jessecheu/port/README.md

# EECS149 Fall 2023 Final Project: Port
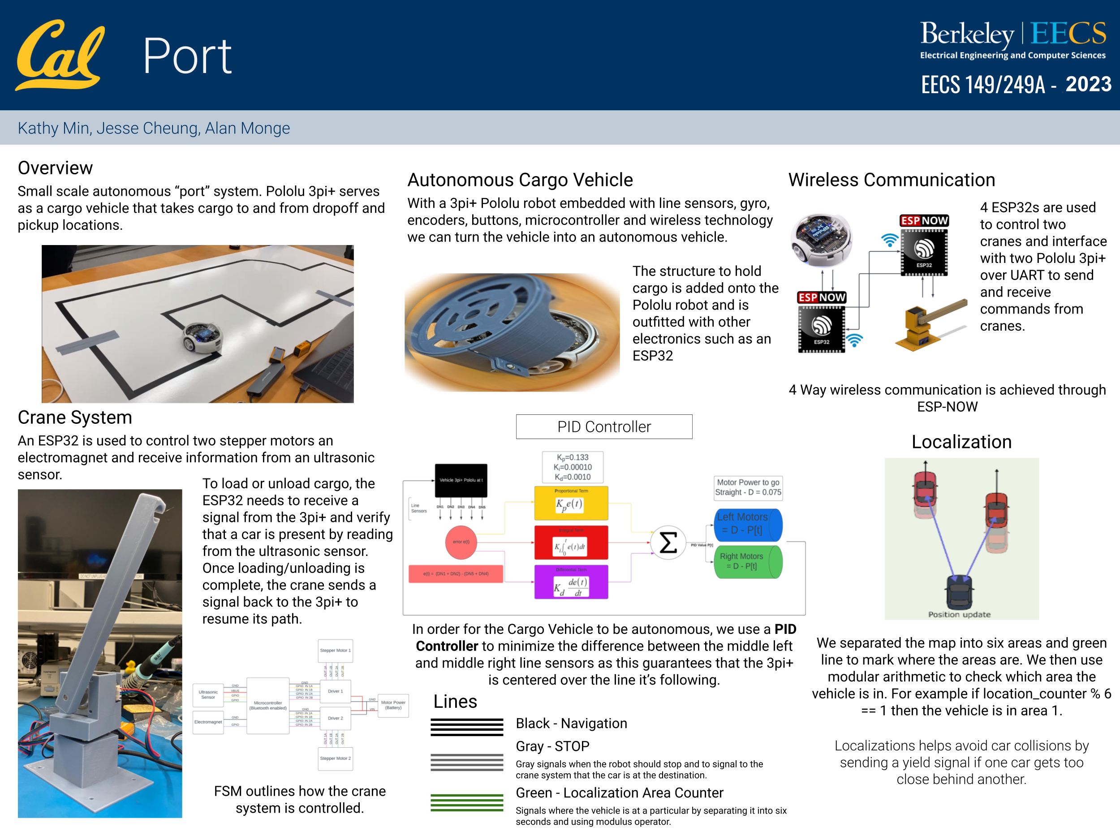
[picture p1: Poster_Landscape.png]
Picture of Port's Poster
