jessecheu/port/crane/esp32_check_mac_address/esp32_check_mac_address.ino

// Complete Instructions to Get and Change ESP MAC Address: https://RandomNerdTutorials.com/get-change-esp32-esp8266-mac-address-arduino/

#include <WiFi.h>
#include <esp_wifi.h>

void setup(){
  Serial.begin(115200);
  Serial.println();
  Serial.print("ESP Board MAC Address:  ");
  Serial.println(WiFi.macAddress());
}
 
void loop(){

}
