jessecheu/port/crane/stepper1/stepper1.ino

#define stepPin 15
#define dirPin 32

void setup() {
  pinMode(stepPin, OUTPUT);
  pinMode(dirPin, OUTPUT);
}

void loop() {
  digitalWrite(dirPin,HIGH);
  for (int x = 0; x<200; x++) {
    digitalWrite(stepPin,HIGH);
    delayMicroseconds(1000);
    digitalWrite(stepPin, LOW);
    delayMicroseconds(1000);
  }
  delay(1000); // 1 second delay.                           

  digitalWrite(dirPin, LOW); // change direction
  for (int x = 0; x<200; x++) {
    digitalWrite(stepPin,HIGH);
    delayMicroseconds(1000);
    digitalWrite(stepPin, LOW);
    delayMicroseconds(1000);
  }
  delay(1000);
}
