jessecheu/port/robot-lib/src/hc_sr04.c

/// @file hc_sr04.c
/// implementation for the hc_sr04 sensor

/*
    hc_sr04.c
    A library for ultrasonic ranger

    Copyright (c) 2012 seeed technology inc.
    Website    : www.seeed.cc
    Author     : LG, FrankieChu
    Create Time: Jan 17,2013
    Change Log :

    The MIT License (MIT)

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
    THE SOFTWARE IS PROVIDED "AS IS", WITHOUT WARRANTY OF ANY KIND, EXPRESS OR
    IMPLIED, INCLUDING BUT NOT LIMITED TO THE WARRANTIES OF MERCHANTABILITY,
    FITNESS FOR A PARTICULAR PURPOSE AND NONINFRINGEMENT. IN NO EVENT SHALL THE
    AUTHORS OR COPYRIGHT HOLDERS BE LIABLE FOR ANY CLAIM, DAMAGES OR OTHER
    LIABILITY, WHETHER IN AN ACTION OF CONTRACT, TORT OR OTHERWISE, ARISING FROM,
    OUT OF OR IN CONNECTION WITH THE SOFTWARE OR THE USE OR OTHER DEALINGS IN
    THE SOFTWARE.
*/

#include <hardware/i2c.h>
#include <hardware/gpio.h>
#include <stdio.h>
#include <string.h>
#include <inttypes.h>
#include "<hc_sr04.h>"

#ifdef ARDUINO_ARCH_STM32F4

static uint32_t MicrosDiff(uint32_t begin, uint32_t end) {
    return end - begin;
}

static uint32_t pulseIn(uint32_t pin, uint32_t state, uint32_t timeout = 1000000L) {
    uint32_t begin = micros();

    // wait for any previous pulse to end
    while (digitalRead(pin)) if (MicrosDiff(begin, micros()) >= timeout) {
            return 0;
        }

    // wait for the pulse to start
    while (!digitalRead(pin)) if (MicrosDiff(begin, micros()) >= timeout) {
            return 0;
        }
    uint32_t pulseBegin = micros();

    // wait for the pulse to stop
    while (digitalRead(pin)) if (MicrosDiff(begin, micros()) >= timeout) {
            return 0;
        }
    uint32_t pulseEnd = micros();

    return MicrosDiff(pulseBegin, pulseEnd);
}

#endif // ARDUINO_ARCH_STM32F4

// Changes pin 24 to be an input in order to read the GPIO pin.
// bool button_c_is_pressed()
// {
//   gpio_set_oeover(0, GPIO_OVERRIDE_LOW);
//   gpio_pull_up(0);
//   sleep_us(1);
//   bool r = !gpio_get(0);
//   gpio_set_oeover(0, GPIO_OVERRIDE_NORMAL);
//   return r;
// }

Ultrasonic::Ultrasonic(int pin) {
    _pin = pin;
}

long Ultrasonic::duration(uint32_t timeout) {
    pinMode(_pin, OUTPUT);
    digitalWrite(_pin, LOW);
    delayMicroseconds(2);
    digitalWrite(_pin, HIGH);
    delayMicroseconds(5);
    digitalWrite(_pin, LOW);
    pinMode(_pin, INPUT);
    long duration;
    duration = pulseIn(_pin, HIGH, timeout);
    return duration;
}

/* The measured distance from the range 0 to 157 inches */
long MeasureInInches(uint32_t timeout) {
    long RangeInInches; 
    RangeInInches = duration(timeout) / 74 / 2;
    return RangeInInches;
}


/*The measured distance from the range 0 to 400 Centimeters*/
long MeasureInCentimeters(uint32_t timeout) {
    long RangeInCentimeters;
    RangeInCentimeters = duration(timeout) / 29 / 2;
    return RangeInCentimeters;
}

/*The measured distance from the range 0 to 4000 Millimeters*/
long MeasureInMillimeters(uint32_t timeout) {
    long RangeInMillimeters;
    RangeInMillimeters = duration(timeout) * (10 / 2) / 29;
    return RangeInMillimeters;
}
