jessecheu/port/robot-lib/src/button.h

// Copyright (C) Pololu Corporation.  See LICENSE.txt for details.

#ifndef BUTTON_H
#define BUTTON_H

#pragma once
/// @file button.h
/// Functions for accessing the pushbuttons on the control board.

#include <stdbool.h>
#include <stdint.h>

/// Returns 1 if button A is pressed, or 0 otherwise.
bool button_a_is_pressed(void);

/// Returns 1 if button B is pressed, or 0 otherwise.
///
/// This function temporarily changes QSPI_SS_N/BOOTSEL to be an input, so it
/// disrupts all access to the flash memory chip.  This function temporarily
/// disables interrupts, but it does nothing to prevent the other core from
/// accesssing flash, so it should not be used in multi-core applications.
///
/// (The Micropython rp2.bootsel_button() method does disable both cores.)
bool button_b_is_pressed(void);

/// Returns 1 if button C is pressed, or 0 otherwise.
bool button_c_is_pressed(void);

/// This struct keeps track of the state of a button for the purpose of
/// detecting debounced button presses and releases.
typedef struct button {
  /// A pointer to the function for reading the button state.
  bool (*is_pressed)(void);

  /// The number of microseconds to require between events (configurable).
  uint32_t debounce_us;

  /// The time of the last event, from ticks_us_32().
  uint32_t last_event_time;

  /// 1 for a press, 0 for a release
  uint8_t last_event;
} button;

/// Creates a button struct to debounce an arbitrary function
/// that takes no arguments and returns a bool.
/// Pass the struct to button_check to check for press and release events.
#define BUTTON_INIT(is_pressed) ((button){ is_pressed, 0, 0, 0 })

/// @brief Checks for a debounced button press or release event.
///
/// This will crash if you use it on an uninitialized button struct.
///
/// @return 0 if no event happened, -1 if the button was released,
/// 1 if it was pressed.
int button_check(button *);


#endif
