jessecheu/port/(commit log)

2023-10-29 copied the code from the templates for the 3pi+ 2040 robot and copied the pico-sdk
2023-10-31 added the MotorsWithFeedback
2023-11-03 need to figure out how to add the MotorWithFeedback so that as the car passes through the line, the power of the motors increases corresponding to what turn we want to do to get it back on track
2023-11-06 changed the logic for the drive so that it uses the most middle sensor and then uses the left and right of the middle sensor as the adjustments, so the robot can now go in a straight line
2023-11-06 changed the values for the motors to get more smooth terms, need to figure out how to add feedback to it instead of a constant value
2023-11-06 working on testing the robot button and also changed the description in the RobotGyroSensors file
2023-11-06 added the button libraries from the pololu example C repo and created a template for the Buttons
2023-11-06 trying to fix the Button by fixing the libraries that were gotten from the reference repo
2023-11-07 solved the issues related to the Buttons, working buttons on the robot now
    [button.h]
2023-11-10 fixing bugs in the Cargo Vehicle System file in regards to switching between calibration and main menu
2023-11-10 fixed issue with the ability to switch between main menu and calibration mode now
2023-11-20 added the uart code for the ESP32 Portion of the Cargo Vehicle
2023-11-25 got the code for i2c communication and ultrasonic sensor
2023-11-26 added more feedback to try to get the vehicle to stay straight when needed and turn when needed. currently able to go in a circle but is very indeterminstic
2023-11-27 working on UART Communication on the RP2040 of the CargoVehicle
2023-11-27 added the UART reading accordingly from the raspberry sdk
2023-12-03 crane code w 2 motorsworking together
2023-12-08 Trying to switch the line following to a PID controller instead of a simple line following
2023-12-08 created a logic of the PID Controller for driving the vehicle
2023-12-08 trying to figure out the correct K values for the PID Controller and added inline turning
2023-12-08 created an extra mode that can adjust the PID K values
2023-12-09 Modified the PID K values and changed up some of the equations
2023-12-09 added Localization by evaluating the distance using the encoders and having a start point
2023-12-09 Current working code that the cargo vehicle and crane works
2023-12-10 ADded the clegg integrator as part of the PID Controller logic which resets the integral term error to zero to handle overshooting issues over the longterm
2023-12-11 Modified the minimum line sensor values to detect the green lines so its easier to detect and added the Localization needed for two vehicles
2023-12-13 Removed the MOVING FORWARD mode and created a timer instead so we can be in DRIVE mode with the PID control and be able to move from the gray line
2023-12-13 Added back the UART + only UART Writing and removed some comments regarding the MOVE_FORWARD
2023-12-13 attempted to fix uart_read
2023-12-13 Added motorsWithFeedback
2023-12-13 trying to figure out the UART
2023-12-13 uart issue fixes
2023-12-13 updated the Arduino related code with the updated mac addresses for the esp32s
